randomplum/autoliv_nv3_uvc/(threads)

Thread 1 (2024-02-06):

Request for Assistance in Integrating NV3 Night Vision into Automotive System

fusang1337, 2024-02-06:
Hello,

I'm interested in integrating the NV3 night vision functionality into my vehicle and came across your repository. I would greatly appreciate it if you could provide any documentation, tutorials, or information on the required hardware to help me understand how to implement this. Any guidance or resources you could provide would be incredibly helpful.

Thank you for your time and assistance.

randomplum, 2024-02-13:
I’m just reusing the sensor as a thermal camera. This project will not help with retrofitting the camera in a car, IIRC for a car integration you’ll need another module that you then code into other car systems.

Thread 2 (2024-02-13):

different J1 - Ask for support

ddubberc, 2024-02-13:
Hi, much appreciate your work!

I have an NV3 with different b2b Connector: in the project uses J1 on pos 13: Molex 52991-0408 (2x20 pin), I see
Molex 52991-0808 (2x40 pin). I cant find straight mapping to the pinout.

I'd like to ask for support for the 80pin board. Tell if I can give any help with this.

Thanks.
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

randomplum, 2024-02-13:
Hi,

I’ve designed the board to interface with the sensor directly, it basically replaces the board in your photo.

randomplum, 2024-02-13:
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
This is how it looks assembled

ddubberc, 2024-02-13:
Thank you! Now I see. I am committed to build at least 2 of this. More questions may come...

Closed 2024-02-13.

Thread 3 (2025-03-14):

BOM list?

ckambiselis, 2025-03-14:
Do you have a BOM file for this, just to make sure the FPGA and other chips are correct?

ckambiselis, 2025-03-14:
Or do you happen to have assembled boards for sale?
