randomplum/autoliv_nv3_uvc/hw/ThermalCam.kicad_pcb

## KiCad design hw/ThermalCam.kicad_pcb (2023-07-12)

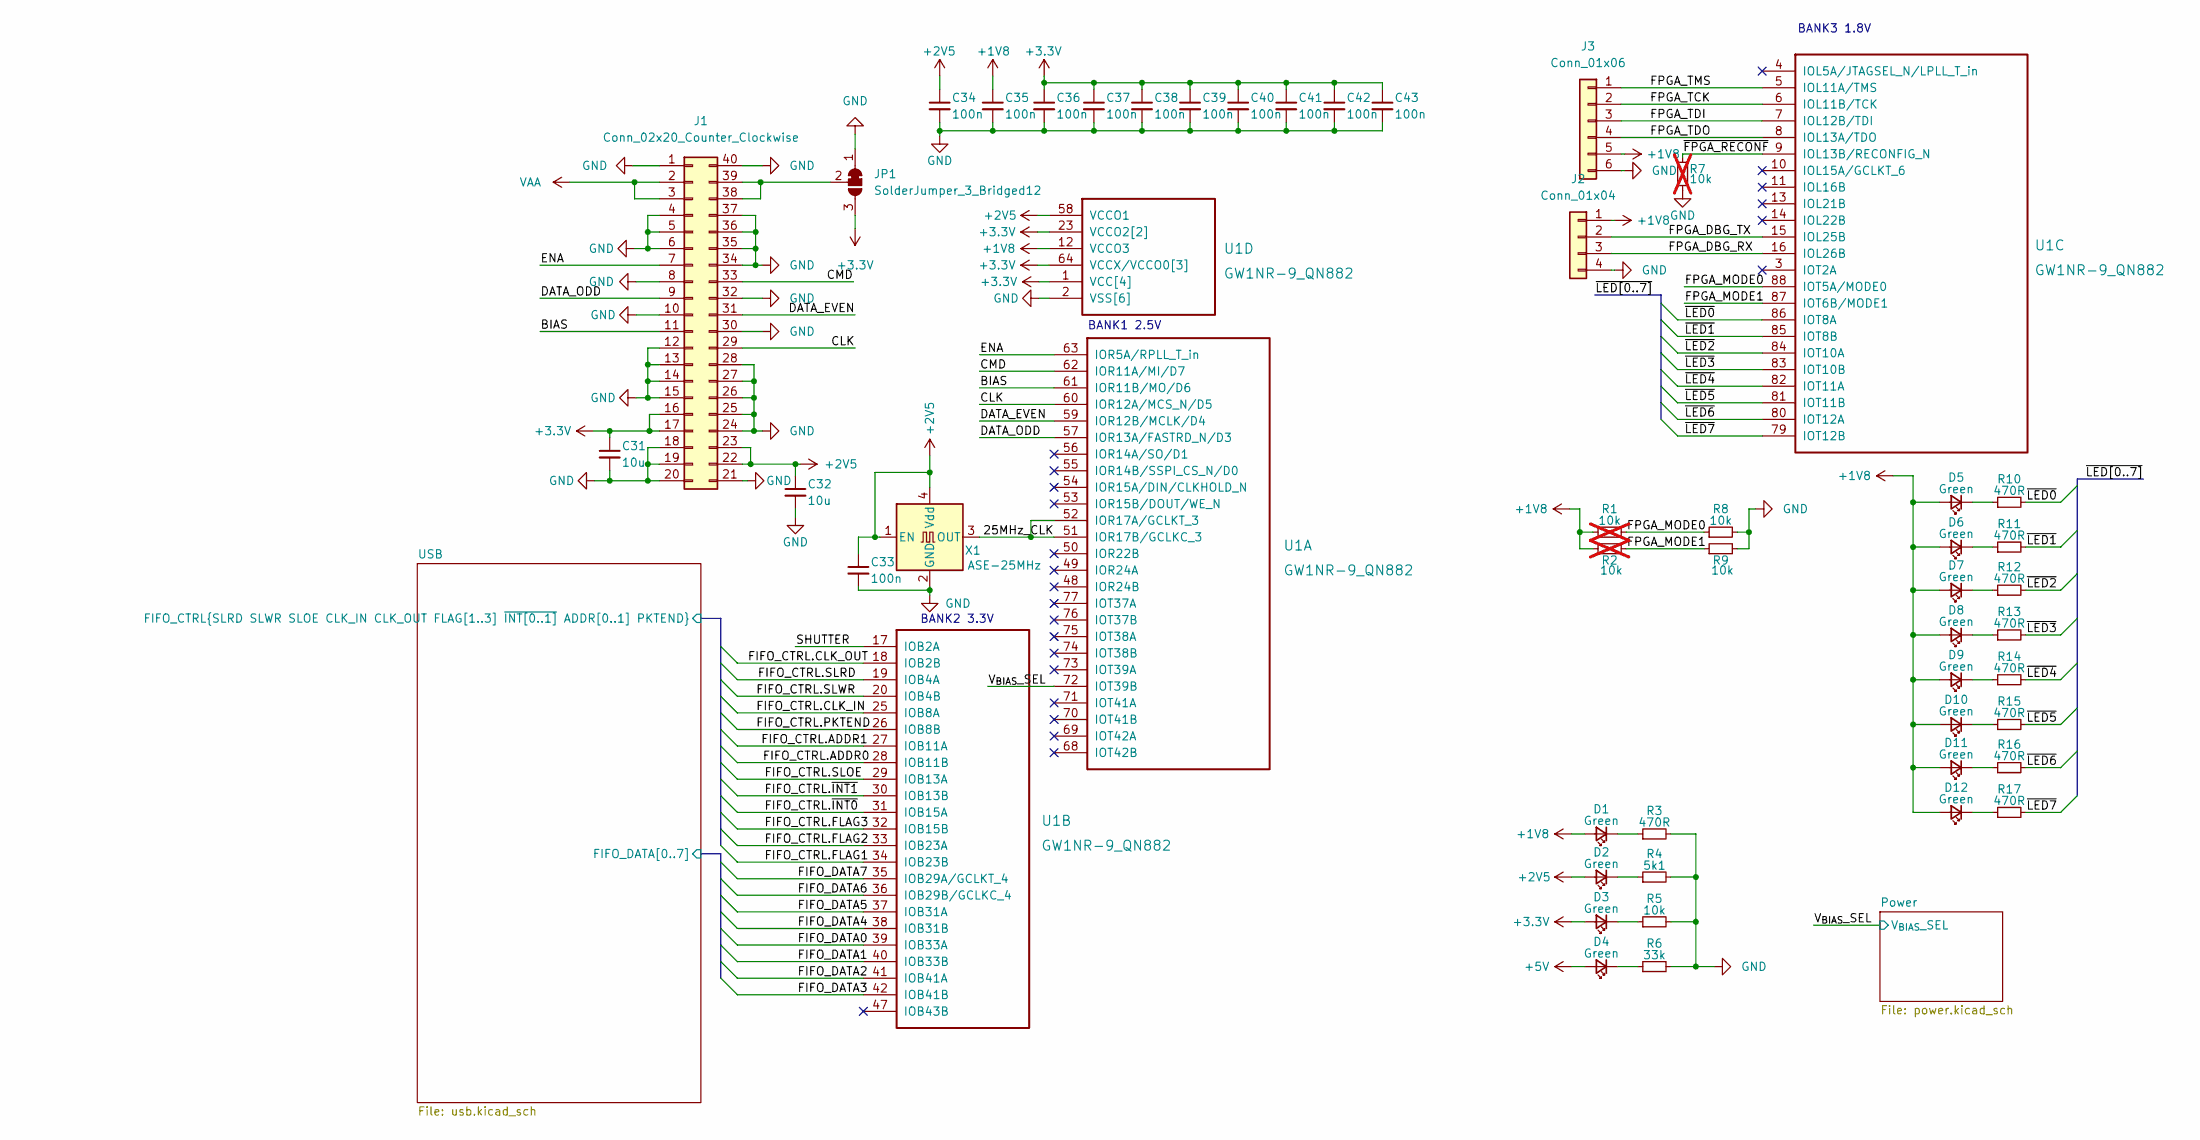
[picture p1: schematic ThermalCam.kicad_sch]

Parts:
C31, C32: 10u; C_0402_1005Metric
C33, C34, C35, C36, C37, C38, C39, C40, C41, C42, C43: 100n; C_0402_1005Metric
D1, D2, D3, D4, D5, D6, D7, D8, D9, D10, D11, D12: Green; LED_0402_1005Metric
J1: Conn_02x20_Counter_Clockwise; 52991-0408
J2: Conn_01x04; PinHeader_1x04_P2.54mm_Vertical
J3: Conn_01x06; PinHeader_1x06_P2.54mm_Vertical
JP1: SolderJumper_3_Bridged12; SolderJumper-3_P1.3mm_Bridged2Bar12_RoundedPad1.0x1.5mm_Num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
R1, R2, R7: 10k; R_0402_1005Metric; not fitted
R3, R10, R11, R12, R13, R14, R15, R16, R17: 470R; R_0402_1005Metric
R4: 5k1; R_0402_1005Metric
R5, R8, R9: 10k; R_0402_1005Metric
R6: 33k; R_0402_1005Metric
U1: GW1NR-9_QN882; QFN-88_EP_10x10_Pitch0.4mm
X1: ASE-25MHz; Oscillator_SMD_Abracon_ASE-4Pin_3.2x2.5mm

Connections:
+1V8: C35.1, D1.2 (A), D5.2 (A), D6.2 (A), D7.2 (A), D8.2 (A), D9.2 (A), D10.2 (A), D11.2 (A), D12.2 (A), J2.1, J3.5, R1.1, R2.1, U1.12 (VCCO3); also elsewhere on the board
+2V5: C32.1, C33.1, C34.1, D2.2 (A), J1.22, J1.23, U1.58 (VCCO1), X1.1 (EN), X1.4 (Vdd); also elsewhere on the board
+3.3V: C31.1, C36.1, C37.1, C38.1, C39.1, C40.1, C41.1, C42.1, C43.1, D3.2 (A), J1.16, J1.17, JP1.3 (B), U1.1 (VCC[4]), U1.22 (VCC[4]), U1.23 (VCCO2[2]), U1.44 (VCCO2[2]), U1.45 (VCC[4]), U1.64 (VCCX/VCCO0[3]), U1.66 (VCC[4]), U1.67 (VCCX/VCCO0[3]), U1.78 (VCCX/VCCO0[3]); also elsewhere on the board
+5V: D4.2 (A); also elsewhere on the board
/25MHz_CLK: U1.51 (IOR17B/GCLKC_3), U1.52 (IOR17A/GCLKT_3), X1.3 (OUT)
/BIAS: J1.11, U1.61 (IOR11B/MO/D6)
/CLK: J1.29, U1.60 (IOR12A/MCS_N/D5)
/CMD: J1.33, U1.62 (IOR11A/MI/D7)
/DATA_EVEN: J1.31, U1.59 (IOR12B/MCLK/D4)
/DATA_ODD: J1.9, U1.57 (IOR13A/FASTRD_N/D3)
/ENA: J1.7, U1.63 (IOR5A/RPLL_T_in)
/FPGA_DBG_RX: J2.3, U1.16 (IOL26B)
/FPGA_DBG_TX: J2.2, U1.15 (IOL25B)
/FPGA_MODE0: R1.2, R8.1, U1.88 (IOT5A/MODE0)
/FPGA_MODE1: R2.2, R9.1, U1.87 (IOT6B/MODE1)
/FPGA_TCK: J3.2, U1.6 (IOL11B/TCK)
/FPGA_TDI: J3.3, U1.7 (IOL12B/TDI)
/FPGA_TDO: J3.4, U1.8 (IOL13A/TDO)
/FPGA_TMS: J3.1, U1.5 (IOL11A/TMS)
/SHUTTER: U1.17 (IOB2A)
/USB/FIFO_CTRL.ADDR0: U1.28 (IOB11B); also elsewhere on the board
/USB/FIFO_CTRL.ADDR1: U1.27 (IOB11A); also elsewhere on the board
/USB/FIFO_CTRL.CLK_IN: U1.25 (IOB8A); also elsewhere on the board
/USB/FIFO_CTRL.CLK_OUT: U1.18 (IOB2B); also elsewhere on the board
/USB/FIFO_CTRL.FLAG1: U1.34 (IOB23B); also elsewhere on the board
/USB/FIFO_CTRL.FLAG2: U1.33 (IOB23A); also elsewhere on the board
/USB/FIFO_CTRL.FLAG3: U1.32 (IOB15B); also elsewhere on the board
/USB/FIFO_CTRL.PKTEND: U1.26 (IOB8B); also elsewhere on the board
/USB/FIFO_CTRL.SLOE: U1.29 (IOB13A); also elsewhere on the board
/USB/FIFO_CTRL.SLRD: U1.19 (IOB4A); also elsewhere on the board
/USB/FIFO_CTRL.SLWR: U1.20 (IOB4B); also elsewhere on the board
/USB/FIFO_CTRL.~INT0: U1.31 (IOB15A); also elsewhere on the board
/USB/FIFO_CTRL.~INT1: U1.30 (IOB13B); also elsewhere on the board
/USB/FIFO_DATA0: U1.39 (IOB33A); also elsewhere on the board
/USB/FIFO_DATA1: U1.40 (IOB33B); also elsewhere on the board
/USB/FIFO_DATA2: U1.41 (IOB41A); also elsewhere on the board
/USB/FIFO_DATA3: U1.42 (IOB41B); also elsewhere on the board
/USB/FIFO_DATA4: U1.38 (IOB31B); also elsewhere on the board
/USB/FIFO_DATA5: U1.37 (IOB31A); also elsewhere on the board
/USB/FIFO_DATA6: U1.36 (IOB29B/GCLKC_4); also elsewhere on the board
/USB/FIFO_DATA7: U1.35 (IOB29A/GCLKT_4); also elsewhere on the board
/V_{BIAS}_SEL: U1.72 (IOT39B); also elsewhere on the board
/~FPGA_RECONF: R7.1, U1.9 (IOL13B/RECONFIG_N)
/~LED0: R10.2, U1.86 (IOT8A)
/~LED1: R11.2, U1.85 (IOT8B)
/~LED2: R12.2, U1.84 (IOT10A)
/~LED3: R13.2, U1.83 (IOT10B)
/~LED4: R14.2, U1.82 (IOT11A)
/~LED5: R15.2, U1.81 (IOT11B)
/~LED6: R16.2, U1.80 (IOT12A)
/~LED7: R17.2, U1.79 (IOT12B)
GND: C31.2, C32.2, C33.2, C34.2, C35.2, C36.2, C37.2, C38.2, C39.2, C40.2, C41.2, C42.2, C43.2, J1.1, J1.4, J1.5, J1.6, J1.8, J1.10, J1.12, J1.13, J1.14, J1.15, J1.18, J1.19, J1.20, J1.21, J1.24, J1.25, J1.26, J1.27, J1.28, J1.30, J1.32, J1.34, J1.35, J1.36, J1.37, J1.40, J2.4, J3.6, JP1.1 (A), R3.2, R4.2, R5.2, R6.2, R7.2, R8.2, R9.2, U1.2 (VSS[6]), U1.21 (VSS[6]), U1.24 (VSS[6]), U1.43 (VSS[6]), U1.46 (VSS[6]), U1.65 (VSS[6]), U1.89 (VSS[6]), X1.2 (GND); also elsewhere on the board
unnamed: D1.1 (K), R3.1
unnamed: D2.1 (K), R4.1
unnamed: D3.1 (K), R5.1
unnamed: D4.1 (K), R6.1
unnamed: D5.1 (K), R10.1
unnamed: D6.1 (K), R11.1
unnamed: D7.1 (K), R12.1
unnamed: D8.1 (K), R13.1
unnamed: D9.1 (K), R14.1
unnamed: D10.1 (K), R15.1
unnamed: D11.1 (K), R16.1
unnamed: D12.1 (K), R17.1
unnamed: J1.38, J1.39, JP1.2 (C)
VAA: J1.2, J1.3; also elsewhere on the board

Notes on the sheet:
BANK3 1.8V
BANK1 2.5V
BANK2 3.3V

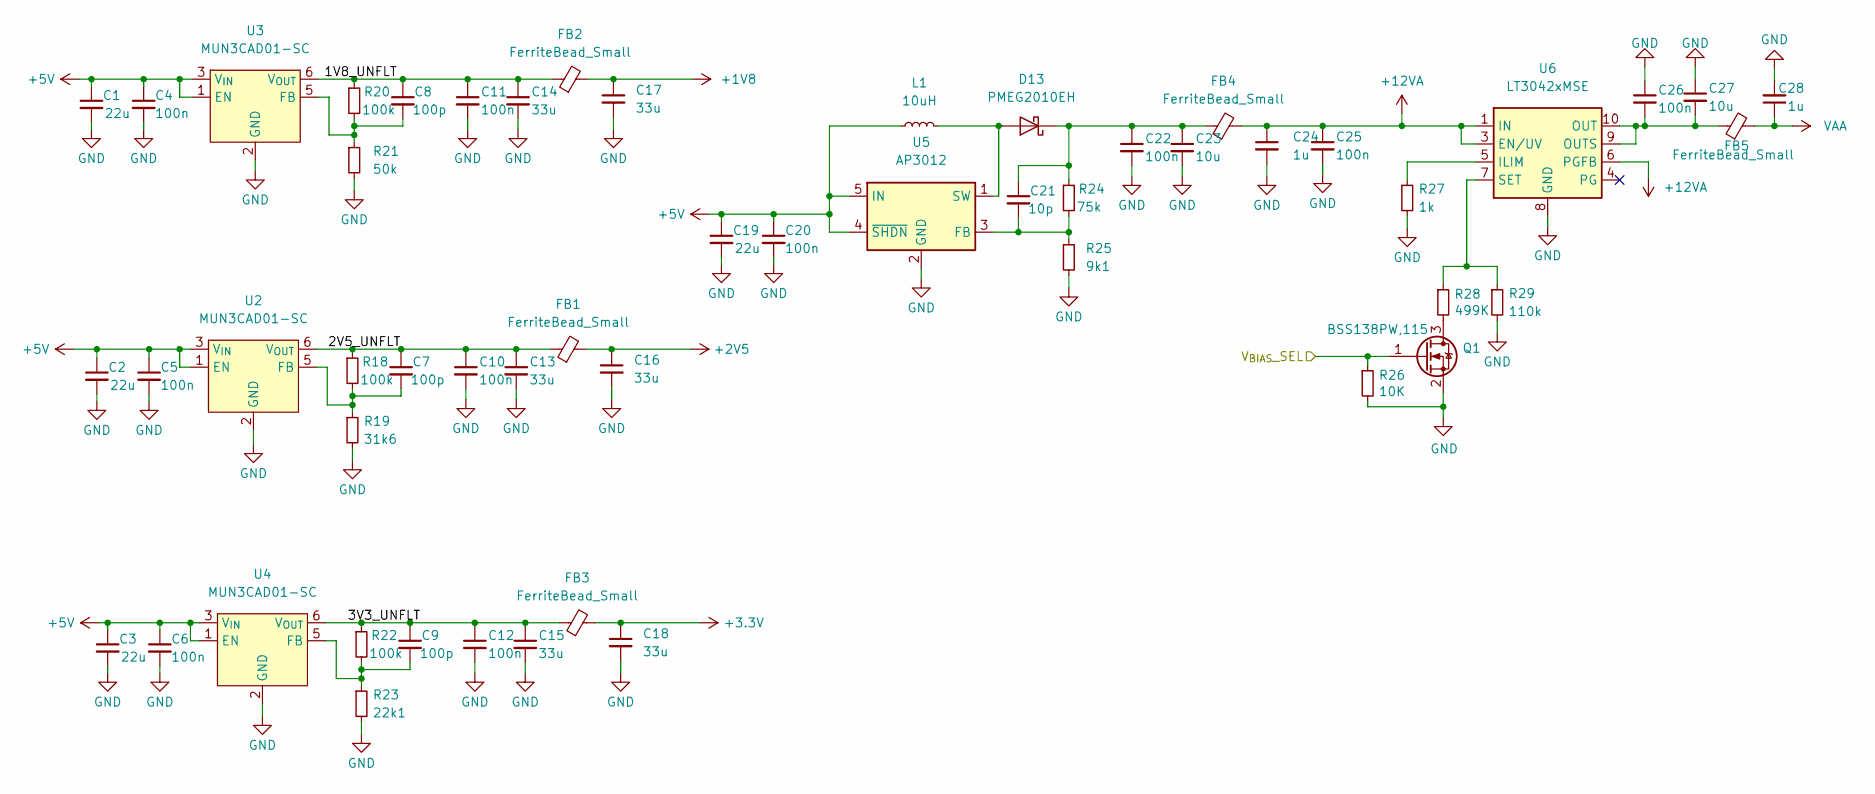
[picture p2: schematic power.kicad_sch]

Parts:
C1, C2, C3, C19: 22u; C_0805_2012Metric
C4, C5, C6, C10, C11, C12, C20, C22, C25, C26: 100n; C_0402_1005Metric
C7, C8, C9: 100p; C_0402_1005Metric
C13, C14, C15, C16, C17, C18: 33u; C_0805_2012Metric
C21: 10p; C_0402_1005Metric
C23, C27: 10u; C_0805_2012Metric
C24, C28: 1u; C_0805_2012Metric
D13: PMEG2010EH; D_SOD-123F
FB1, FB2, FB3, FB4, FB5: FerriteBead_Small; L_0603_1608Metric
L1: 10uH; L_1812_4532Metric
Q1: BSS138PW,115; SOT-323_SC-70; MPN BSS138PW,115
R18, R20, R22: 100k; R_0402_1005Metric
R19: 31k6; R_0402_1005Metric
R21: 50k; R_0402_1005Metric
R23: 22k1; R_0402_1005Metric
R24: 75k; R_0402_1005Metric
R25: 9k1; R_0402_1005Metric
R26: 10K; R_0402_1005Metric
R27: 1k; R_0402_1005Metric
R28: 499K; R_0402_1005Metric
R29: 110k; R_0402_1005Metric
U2, U3, U4: MUN3CAD01-SC; MUN3CAD01
U5: AP3012; SOT-23-5
U6: LT3042xMSE; MSOP-10-1EP_3x3mm_P0.5mm_EP1.68x1.88mm

Connections:
+1V8: C17.1, FB2.2; also elsewhere on the board
+2V5: C16.1, FB1.2; also elsewhere on the board
+3.3V: C18.1, FB3.2; also elsewhere on the board
+5V: C1.1, C2.1, C3.1, C4.1, C5.1, C6.1, C19.1, C20.1, L1.1, U2.1 (EN), U2.3 (V_{IN}), U3.1 (EN), U3.3 (V_{IN}), U4.1 (EN), U4.3 (V_{IN}), U5.4 (~SHDN), U5.5 (IN); also elsewhere on the board
+12VA: C24.1, C25.1, FB4.2, U6.1 (IN), U6.2 (IN), U6.3 (EN/UV), U6.6 (PGFB)
/Power/1V8_UNFLT: C8.1, C11.1, C14.1, FB2.1, R20.1, U3.6 (V_{OUT})
/Power/2V5_UNFLT: C7.1, C10.1, C13.1, FB1.1, R18.1, U2.6 (V_{OUT})
/Power/3V3_UNFLT: C9.1, C12.1, C15.1, FB3.1, R22.1, U4.6 (V_{OUT})
/V_{BIAS}_SEL: Q1.1 (G), R26.1; also elsewhere on the board
GND: C1.2, C2.2, C3.2, C4.2, C5.2, C6.2, C10.2, C11.2, C12.2, C13.2, C14.2, C15.2, C16.2, C17.2, C18.2, C19.2, C20.2, C22.2, C23.2, C24.2, C25.2, C26.1, C27.1, C28.2, Q1.2 (S), R19.2, R21.2, R23.2, R25.2, R26.2, R27.2, R29.2, U2.2 (GND), U2.4 (GND), U3.2 (GND), U3.4 (GND), U4.2 (GND), U4.4 (GND), U5.2 (GND), U6.8 (GND), U6.11 (GND); also elsewhere on the board
unnamed: D13.2 (A), L1.2, U5.1 (SW)
unnamed: C21.1, C22.1, C23.1, D13.1 (K), FB4.1, R24.1
unnamed: Q1.3 (D), R28.2
unnamed: C7.2, R18.2, R19.1, U2.5 (FB)
unnamed: C8.2, R20.2, R21.1, U3.5 (FB)
unnamed: C9.2, R22.2, R23.1, U4.5 (FB)
unnamed: C21.2, R24.2, R25.1, U5.3 (FB)
unnamed: R27.1, U6.5 (ILIM)
unnamed: C26.2, C27.2, FB5.1, U6.9 (OUTS), U6.10 (OUT)
unnamed: R28.1, R29.1, U6.7 (SET)
VAA: C28.1, FB5.2; also elsewhere on the board

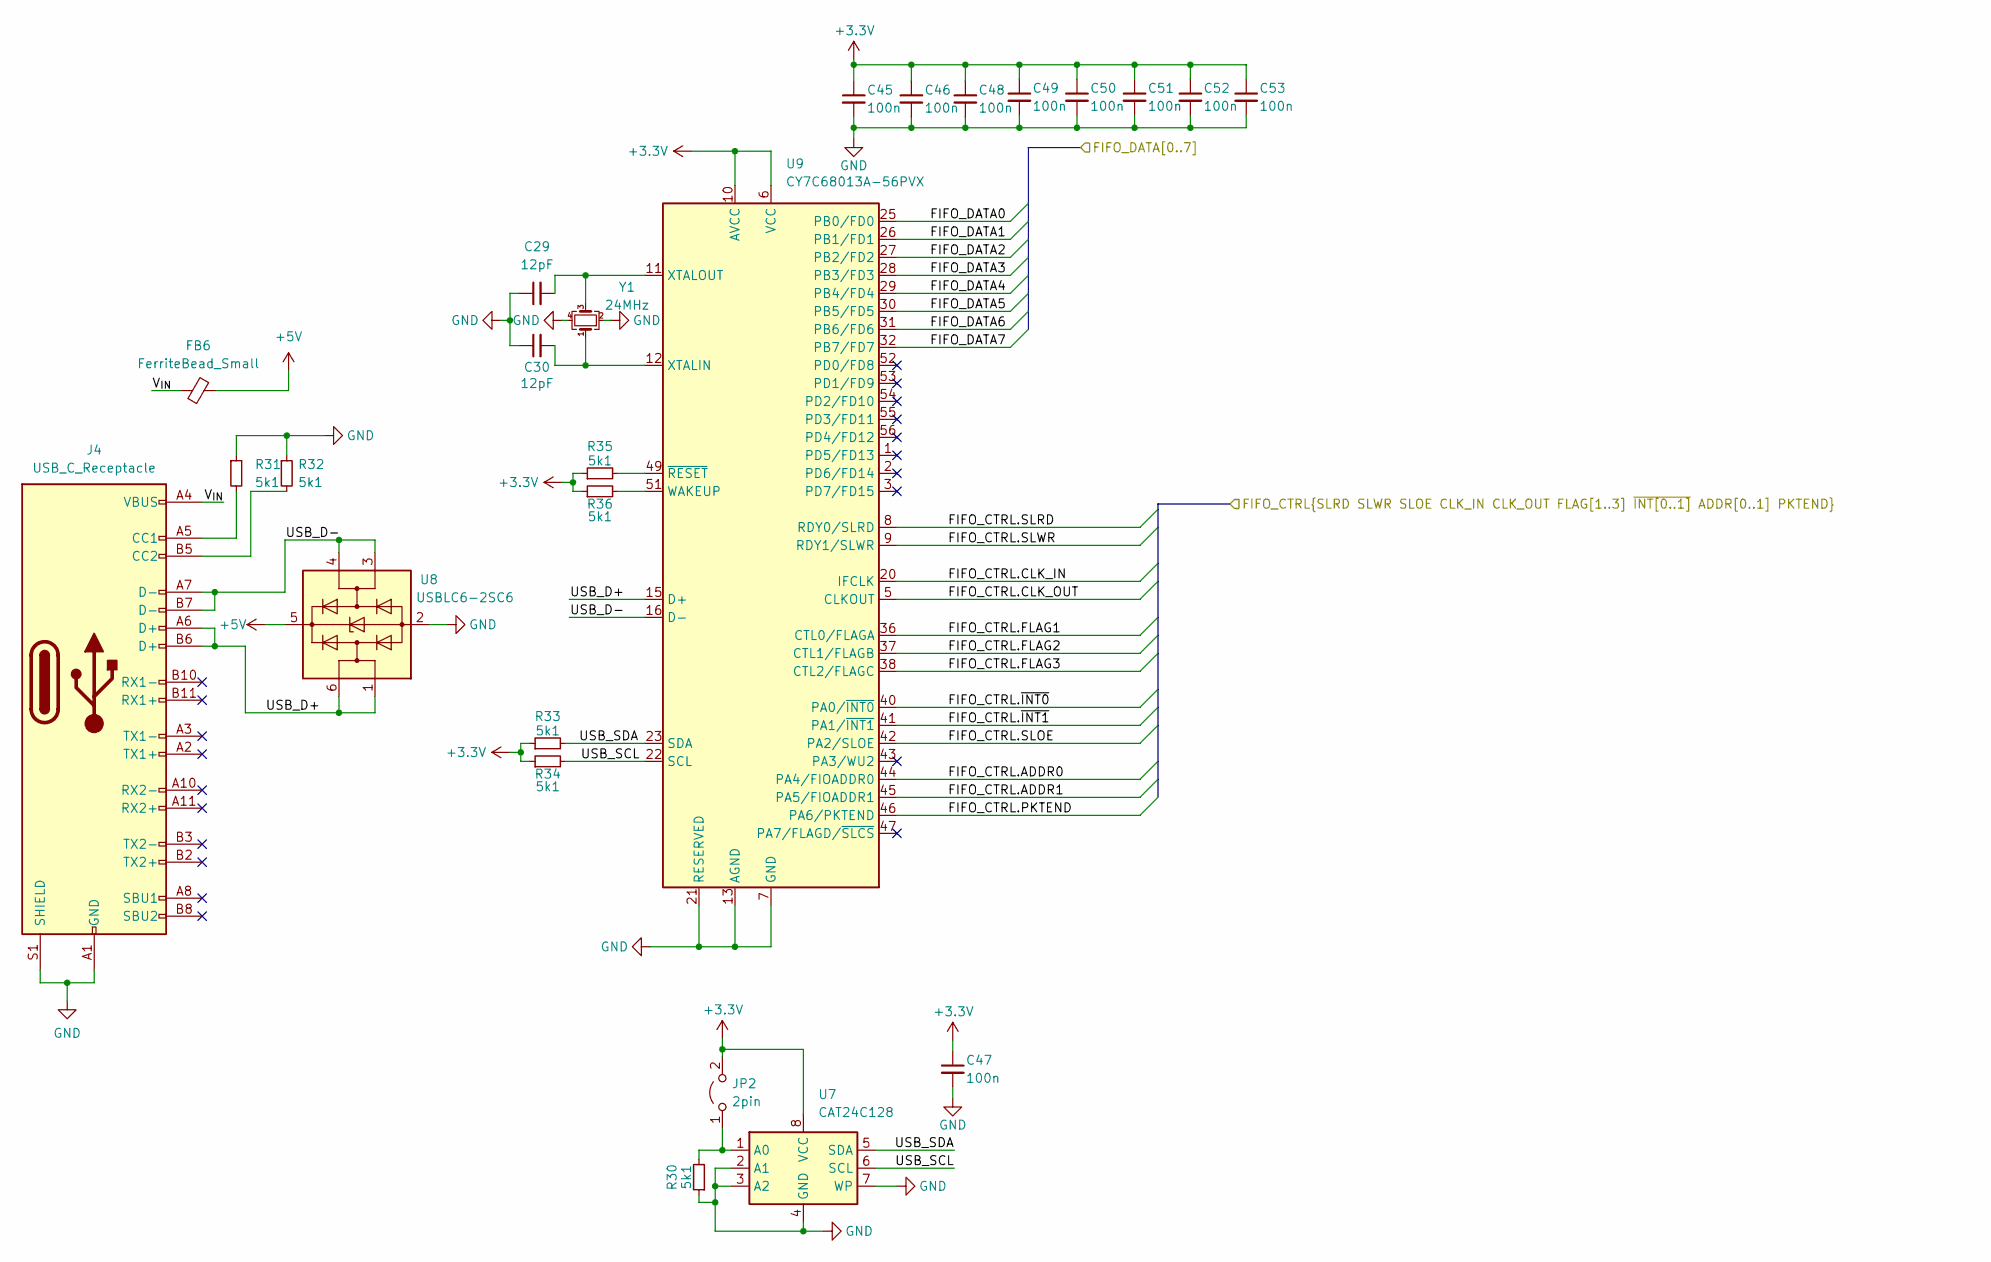
[picture p3: schematic usb.kicad_sch]

Parts:
C29, C30: 12pF; C_0402_1005Metric
C45, C46, C47, C48, C49, C50, C51, C52, C53: 100n; C_0402_1005Metric
FB6: FerriteBead_Small; L_0603_1608Metric
J4: USB_C_Receptacle; USB_C_Receptacle_JAE_DX07S024WJ3R400
JP2: 2pin; PinHeader_1x02_P2.54mm_Vertical
R30, R31, R32, R33, R34, R35, R36: 5k1; R_0402_1005Metric
U7: CAT24C128; TSSOP-8_4.4x3mm_P0.65mm
U8: USBLC6-2SC6; SOT-23-6
U9: CY7C68013A-56PVX; SSOP-56_7.5x18.5mm_P0.635mm
Y1: 24MHz; Crystal_SMD_Abracon_ABM8G-4Pin_3.2x2.5mm

Connections:
+3.3V: C45.1, C46.1, C47.1, C48.1, C49.1, C50.1, C51.1, C52.1, C53.1, JP2.2 (B), R33.1, R34.1, R35.1, R36.1, U7.8 (VCC), U9.6 (VCC), U9.10 (AVCC), U9.14 (AVCC), U9.18 (VCC), U9.24 (VCC), U9.34 (VCC), U9.39 (VCC), U9.50 (VCC); also elsewhere on the board
+5V: FB6.2, U8.5 (VBUS); also elsewhere on the board
/USB/FIFO_CTRL.ADDR0: U9.44 (PA4/FIOADDR0); also elsewhere on the board
/USB/FIFO_CTRL.ADDR1: U9.45 (PA5/FIOADDR1); also elsewhere on the board
/USB/FIFO_CTRL.CLK_IN: U9.20 (IFCLK); also elsewhere on the board
/USB/FIFO_CTRL.CLK_OUT: U9.5 (CLKOUT); also elsewhere on the board
/USB/FIFO_CTRL.FLAG1: U9.36 (CTL0/FLAGA); also elsewhere on the board
/USB/FIFO_CTRL.FLAG2: U9.37 (CTL1/FLAGB); also elsewhere on the board
/USB/FIFO_CTRL.FLAG3: U9.38 (CTL2/FLAGC); also elsewhere on the board
/USB/FIFO_CTRL.PKTEND: U9.46 (PA6/PKTEND); also elsewhere on the board
/USB/FIFO_CTRL.SLOE: U9.42 (PA2/SLOE); also elsewhere on the board
/USB/FIFO_CTRL.SLRD: U9.8 (RDY0/SLRD); also elsewhere on the board
/USB/FIFO_CTRL.SLWR: U9.9 (RDY1/SLWR); also elsewhere on the board
/USB/FIFO_CTRL.~INT0: U9.40 (PA0/~INT0); also elsewhere on the board
/USB/FIFO_CTRL.~INT1: U9.41 (PA1/~INT1); also elsewhere on the board
/USB/FIFO_DATA0: U9.25 (PB0/FD0); also elsewhere on the board
/USB/FIFO_DATA1: U9.26 (PB1/FD1); also elsewhere on the board
/USB/FIFO_DATA2: U9.27 (PB2/FD2); also elsewhere on the board
/USB/FIFO_DATA3: U9.28 (PB3/FD3); also elsewhere on the board
/USB/FIFO_DATA4: U9.29 (PB4/FD4); also elsewhere on the board
/USB/FIFO_DATA5: U9.30 (PB5/FD5); also elsewhere on the board
/USB/FIFO_DATA6: U9.31 (PB6/FD6); also elsewhere on the board
/USB/FIFO_DATA7: U9.32 (PB7/FD7); also elsewhere on the board
/USB/USB_D+: J4.A6 (D+), J4.B6 (D+), U8.1 (I/O1), U8.6 (I/O1), U9.15 (D+)
/USB/USB_D-: J4.A7 (D-), J4.B7 (D-), U8.3 (I/O2), U8.4 (I/O2), U9.16 (D-)
/USB/USB_SCL: R34.2, U7.6 (SCL), U9.22 (SCL)
/USB/USB_SDA: R33.2, U7.5 (SDA), U9.23 (SDA)
/USB/V_{IN}: FB6.1, J4.A4 (VBUS), J4.A9 (VBUS), J4.B4 (VBUS), J4.B9 (VBUS)
GND: C29.1, C30.1, C45.2, C46.2, C47.2, C48.2, C49.2, C50.2, C51.2, C52.2, C53.2, J4.A1 (GND), J4.A12 (GND), J4.B1 (GND), J4.B12 (GND), J4.S1 (SHIELD), R30.1, R31.1, R32.1, U7.2 (A1), U7.3 (A2), U7.4 (GND), U7.7 (WP), U8.2 (GND), U9.4 (GND), U9.7 (GND), U9.13 (AGND), U9.17 (AGND), U9.19 (GND), U9.21 (RESERVED), U9.33 (GND), U9.35 (GND), U9.48 (GND), Y1.2, Y1.4; also elsewhere on the board
unnamed: J4.A5 (CC1), R31.2
unnamed: J4.B5 (CC2), R32.2
unnamed: JP2.1 (A), R30.2, U7.1 (A0)
unnamed: R36.2, U9.51 (WAKEUP)
unnamed: C30.2, U9.12 (XTALIN), Y1.1
unnamed: C29.2, U9.11 (XTALOUT), Y1.3
unnamed: R35.2, U9.49 (~RESET)

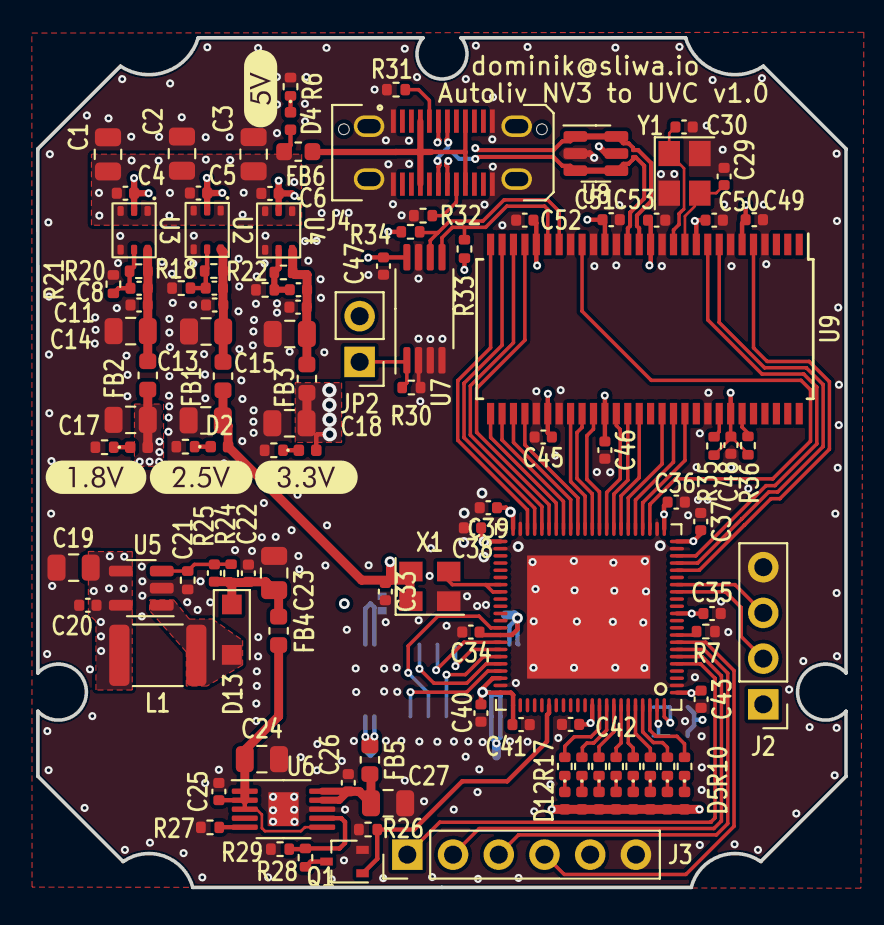
[picture p4: board ThermalCam.kicad_pcb from above]

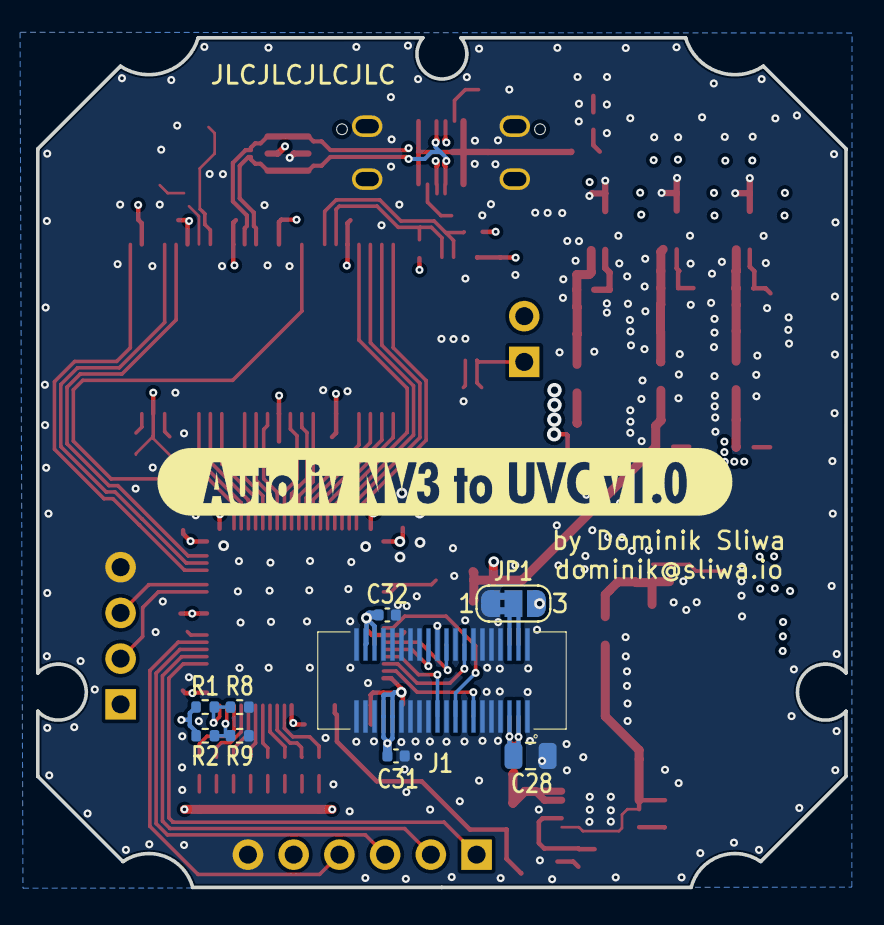
[picture p5: board ThermalCam.kicad_pcb from below]

Board: 4 copper layers, 44.9 x 47.2 mm, 131 parts (10 on the bottom side), 91 nets.

Other parts of the board:
kibuzzard-636D73F4: G***; kibuzzard-636D73F4
kibuzzard-636D765E: G***; kibuzzard-636D765E
kibuzzard-636D7417: G***; kibuzzard-636D7417
kibuzzard-636D7427: G***; kibuzzard-636D7427
kibuzzard-636D7435: G***; kibuzzard-636D7435
