randomplum/autoliv_nv3_uvc/sw/fx2/firmware.c

/**
 * Copyright (C) 2009 Ubixum, Inc. 
 *
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
 * You should have received a copy of the GNU Lesser General Public
 * License along with this library; if not, write to the Free Software
 * Foundation, Inc., 51 Franklin Street, Fifth Floor, Boston, MA  02110-1301  USA
 **/

#define printf(...)

#include <fx2macros.h>
#include <fx2ints.h>
#include <autovector.h>
#include <delay.h>
#include <setupdat.h>

#define SYNCDELAY SYNCDELAY4

volatile __bit dosud=FALSE;
volatile __bit dosuspend=FALSE;

// custom functions
extern void main_loop(void);
extern void main_init(void);


void main(void) {

 main_init();

 // set up interrupts.
 USE_USB_INTS();

 ENABLE_SUDAV();
 ENABLE_USBRESET();
 ENABLE_HISPEED();
 ENABLE_SUSPEND();
 ENABLE_RESUME();

 EA=1;

// iic files (c2 load) don't need to renumerate/delay
// trm 3.6
#ifndef NORENUM
 RENUMERATE();
#else
 USBCS &= ~bmDISCON;
#endif

 while(TRUE) {

     main_loop();

     if (dosud) {
       dosud=FALSE;
       handle_setupdata();
     }

#ifdef SUSPEND_ENABLED
     if (dosuspend) {
        dosuspend=FALSE;
        do {
           printf ( "I'm going to Suspend.\n" );
           WAKEUPCS |= bmWU|bmWU2; // make sure ext wakeups are cleared
           SUSPEND=1;
           PCON |= 1;
           __asm
           nop
           nop
           nop
           nop
           nop
           nop
           nop
           __endasm;
        } while ( !remote_wakeup_allowed && REMOTE_WAKEUP()); 
        printf ( "I'm going to wake up.\n");

        // resume
        // trm 6.4
        if ( REMOTE_WAKEUP() ) {
            delay(5);
            USBCS |= bmSIGRESUME;
            delay(15);
            USBCS &= ~bmSIGRESUME;
        }

     }
#endif
 } // end while

} // end main

void resume_isr(void) __interrupt (RESUME_ISR) {
 CLEAR_RESUME();
}

void sudav_isr(void) __interrupt (SUDAV_ISR) {
 dosud=TRUE;
 CLEAR_SUDAV();
}
void usbreset_isr(void) __interrupt (USBRESET_ISR) {
 handle_hispeed(FALSE);
 CLEAR_USBRESET();
}
void hispeed_isr(void) __interrupt (HISPEED_ISR) {
 handle_hispeed(TRUE);
 CLEAR_HISPEED();
}

void suspend_isr(void) __interrupt (SUSPEND_ISR) {
 dosuspend=TRUE;
 CLEAR_SUSPEND();
}


void ISR_USART0(void) __interrupt (TI_0_ISR) __critical {

}
