randomplum/autoliv_nv3_uvc/(commit log)

2022-11-07 ThermalCam: initial schematics
    [ThermalCam.kicad_pcb, ThermalCam.kicad_sch, power.kicad_sch, usb.kicad_sch]
2022-11-10 Autoliv NV3 to UVC v1.0
    [ThermalCam.kicad_pcb, ThermalCam.kicad_sch, power.kicad_sch, usb.kicad_sch]
2023-07-08 schematic fixes and adding sw section
    [ThermalCam.kicad_pcb, ThermalCam.kicad_sch, power.kicad_sch, usb.kicad_sch]
2023-07-08 q: fx2: sdcc 4.3.0 fixes
    [firmware.c, read-serialno.c, read-serialno.h, uvc.c]
2023-07-12 working UVC demo
    [ThermalCam.kicad_pcb, usb.kicad_sch]
